UCSD-E4E/FishSense-PIO/fishsense2.step

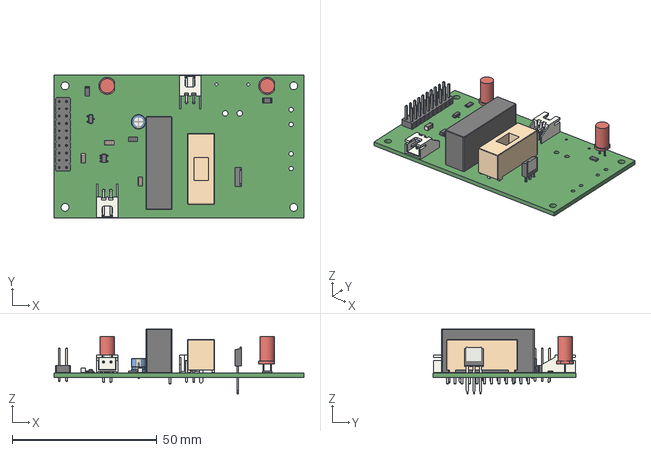
[picture p1: CAD file, 2021-12-12]
fishsense2.step
86.4 x 49.5 x 22.4 mm
