UCSD-E4E/FishSense-PIO/fishsense2.kicad_pcb

## KiCad design fishsense2.kicad_pcb (2022-05-04)

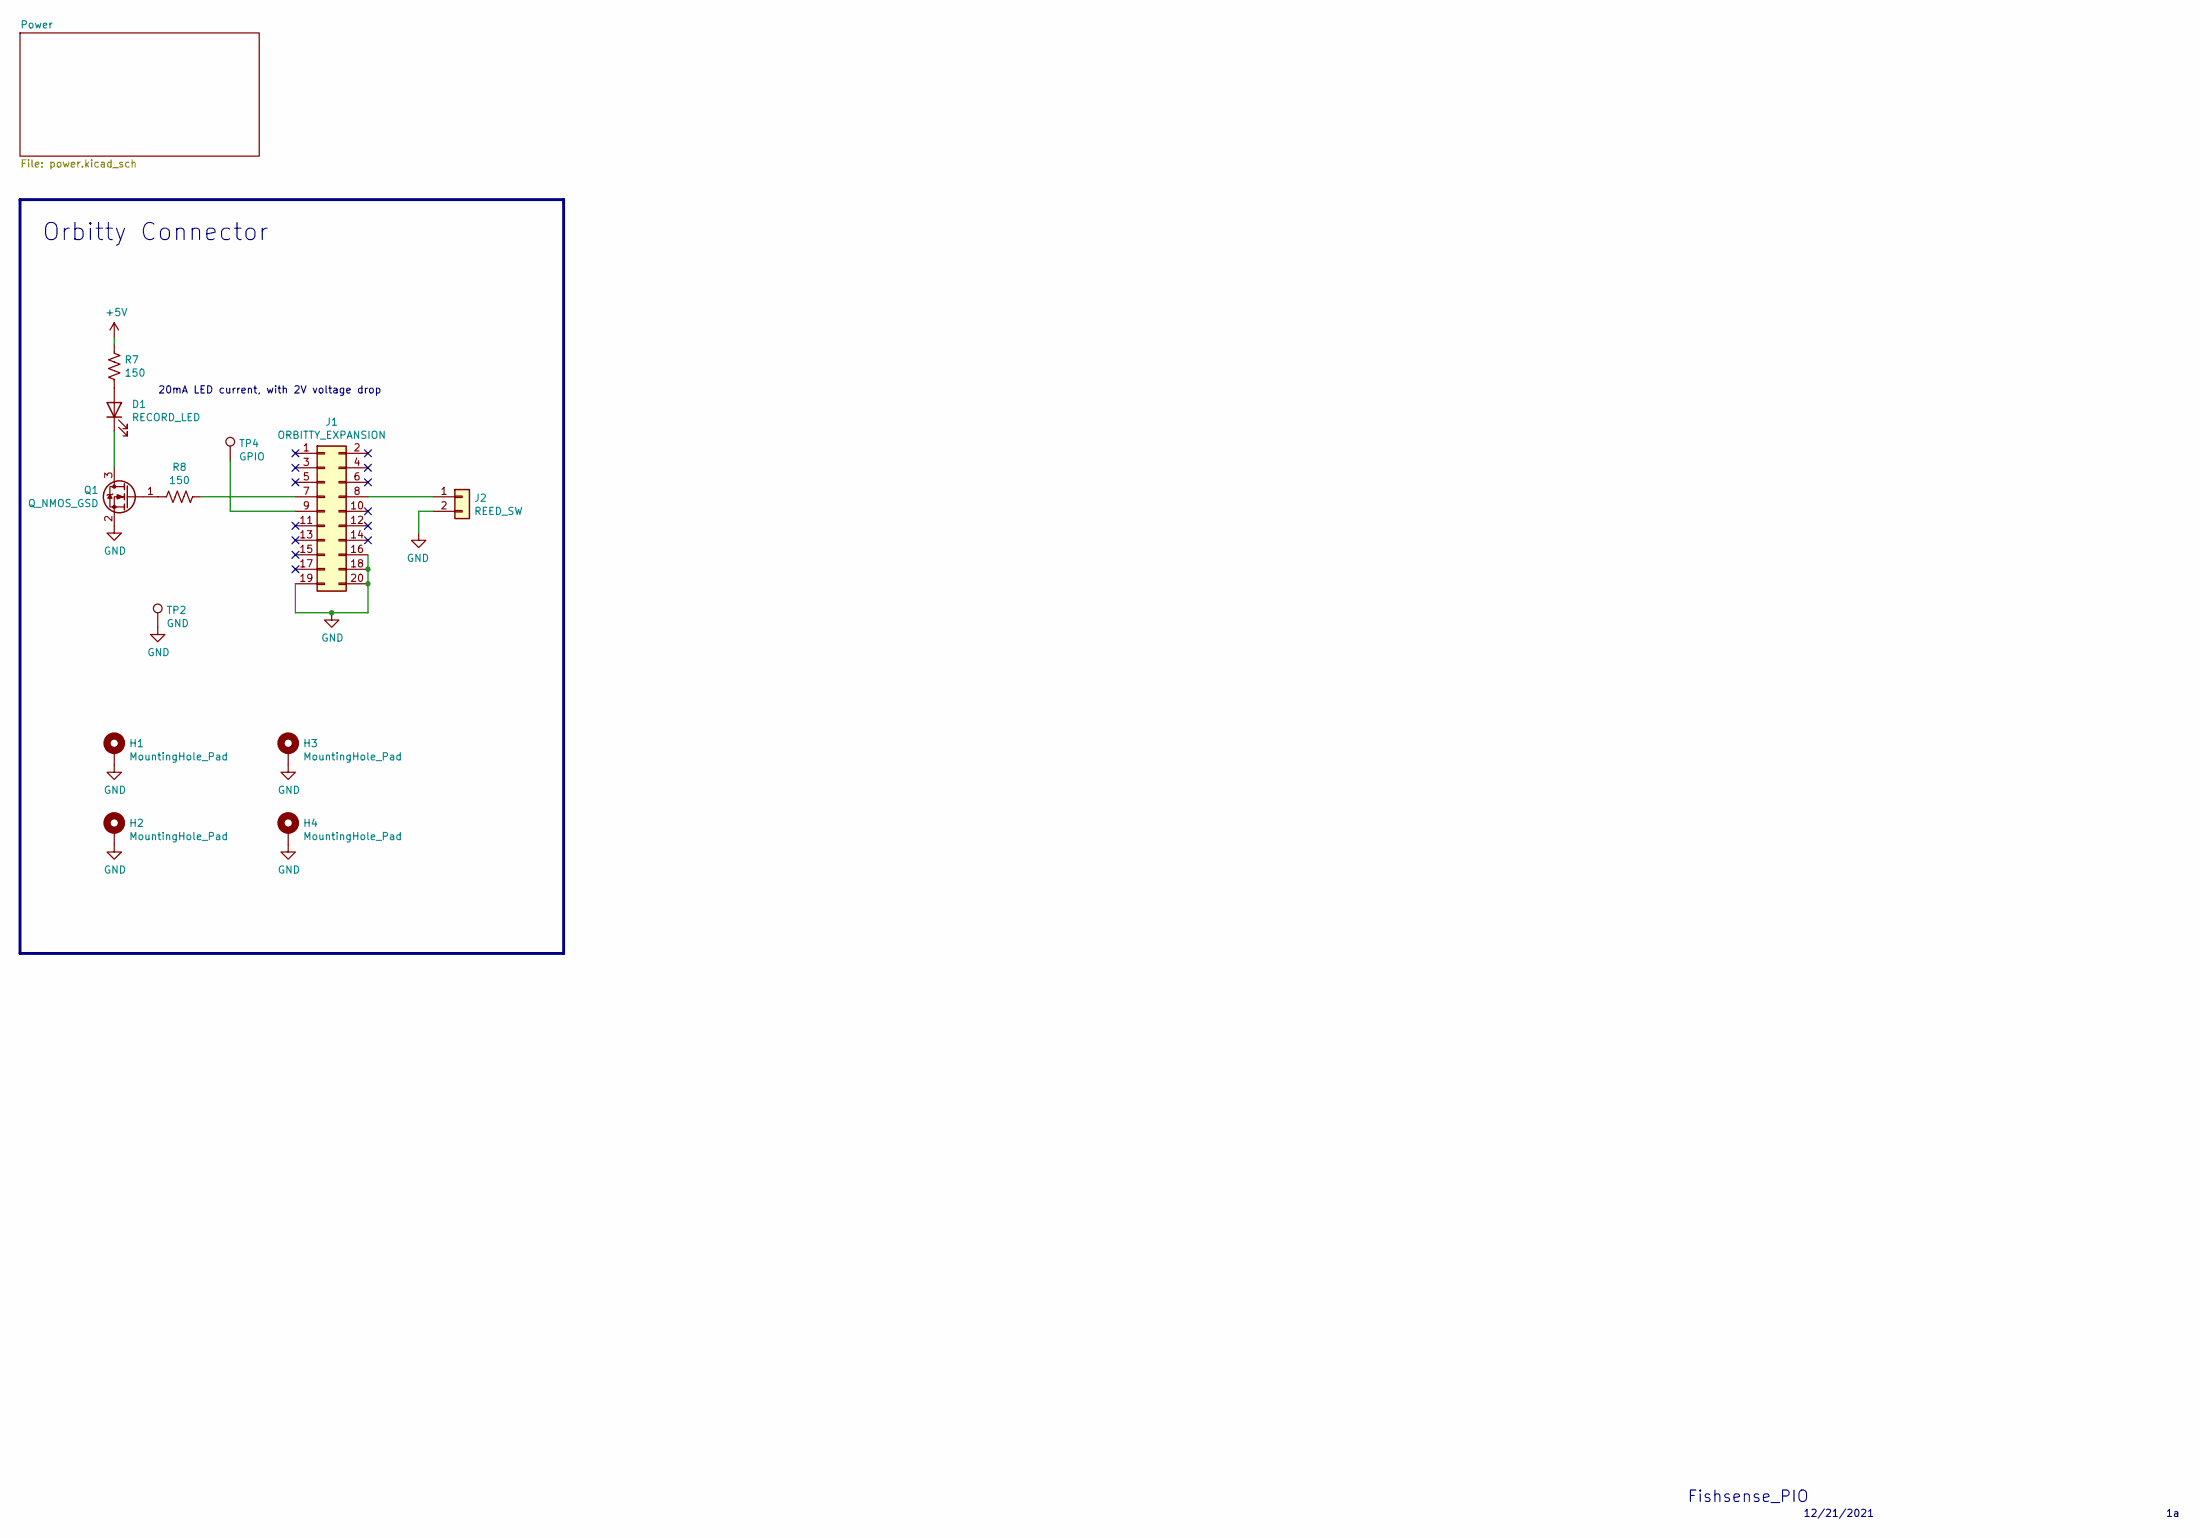
[picture p2: schematic fishsense2.kicad_sch]

Parts:
D1: RECORD_LED; LED_D5.0mm_FlatTop
H1, H2, H3, H4: MountingHole_Pad; MountingHole_2.7mm_M2.5_Pad
J1: ORBITTY_EXPANSION; PinSocket_2x10_P2.54mm_Vertical
J2: REED_SW; JST_XH_S2B-XH-A_1x02_P2.50mm_Horizontal
Q1: Q_NMOS_GSD; SOT-23_Handsoldering
R7, R8: 150; R_1206_3216Metric_Pad1.30x1.75mm_HandSolder
TP2: GND; TestPoint_Plated_Hole_D2.0mm
TP4: GPIO; TestPoint_Plated_Hole_D2.0mm

Connections:
+5V: R7.1; also elsewhere on the board
GND: H1.1, H2.1, H3.1, H4.1, J1.16, J1.18, J1.19, J1.20, J2.2, Q1.2 (S), TP2.1; also elsewhere on the board
unnamed: D1.1 (K), Q1.3 (D)
unnamed: D1.2 (A), R7.2
unnamed: J1.7, R8.1
unnamed: J1.8, J2.1
unnamed: J1.9, TP4.1
unnamed: Q1.1 (G), R8.2

Notes on the sheet:
20mA LED current, with 2V voltage drop
12/21/2021
Orbitty Connector
Fishsense_PIO

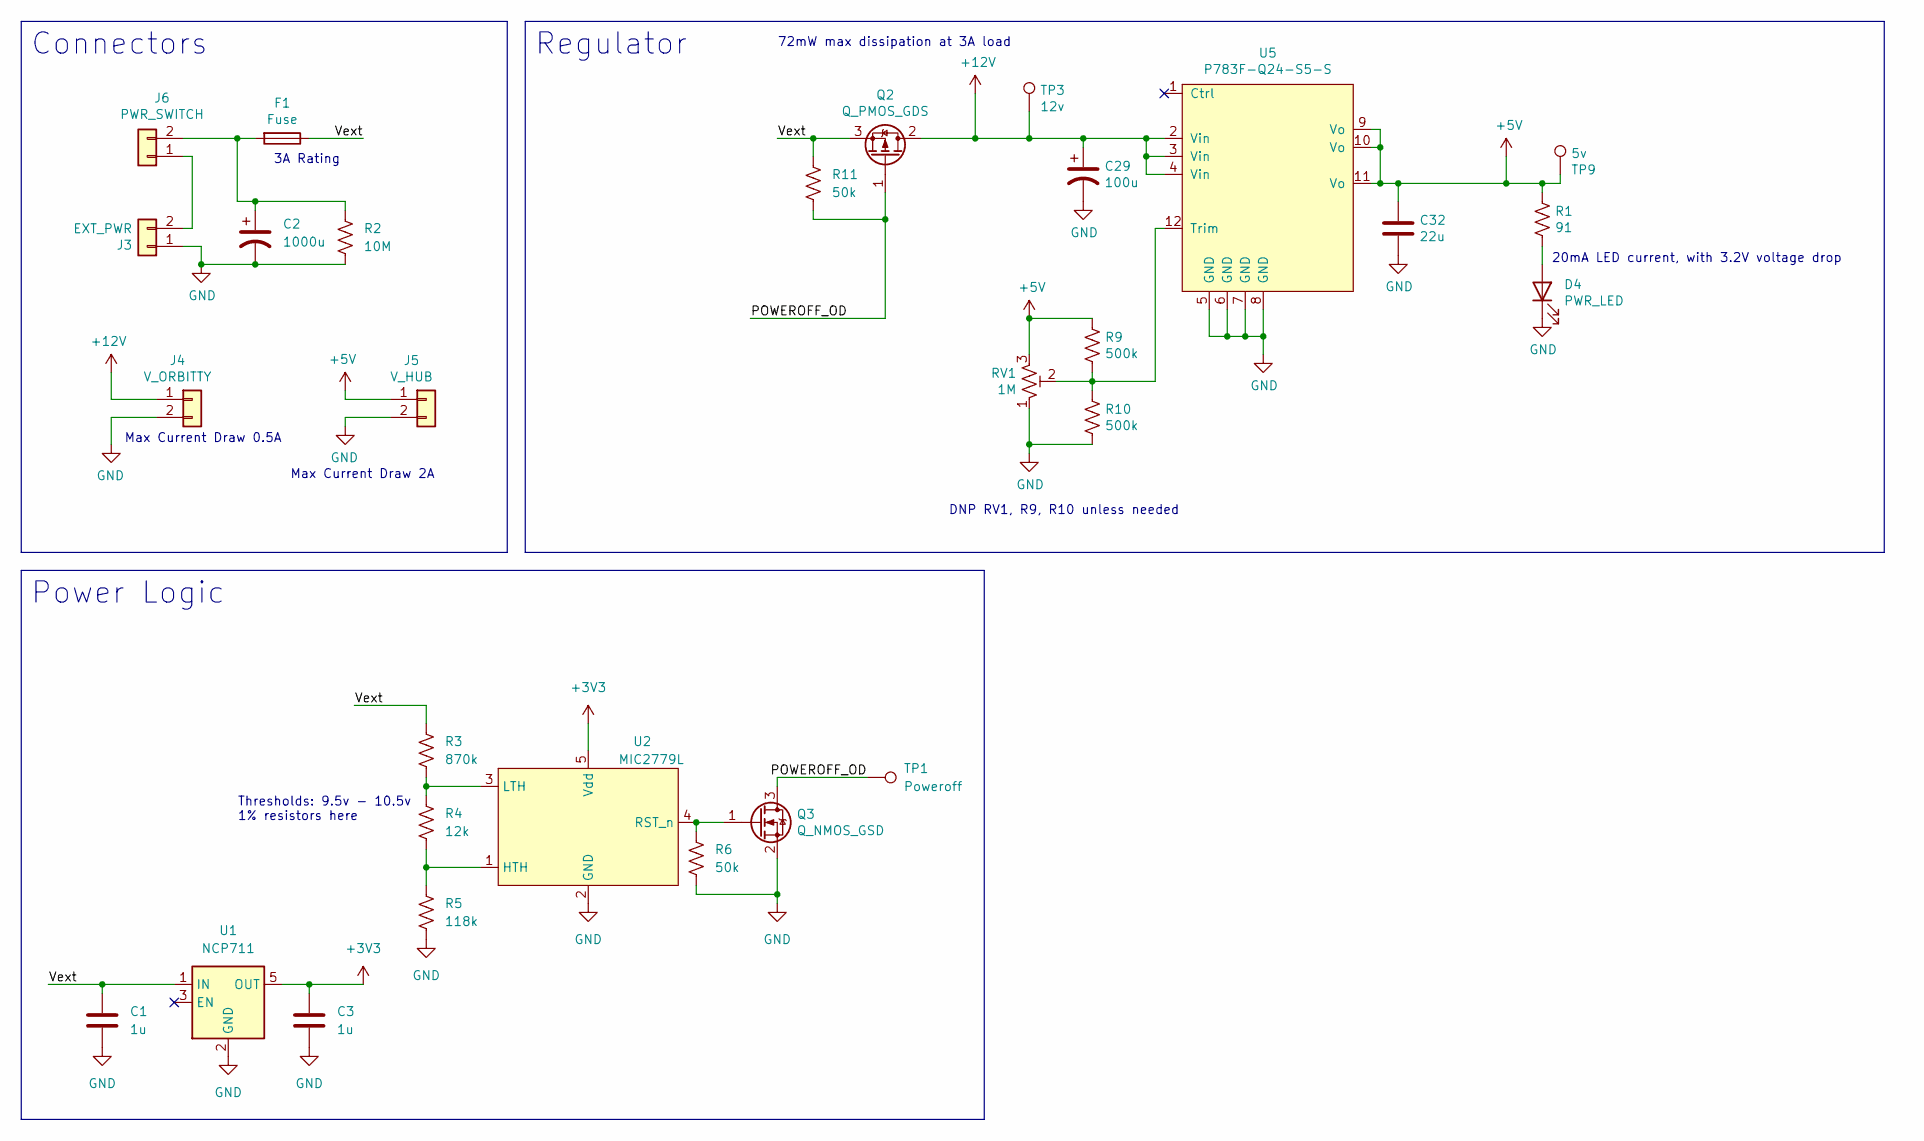
[picture p3: schematic power.kicad_sch]

Parts:
C1, C3: 1u; C_1206_3216Metric_Pad1.33x1.80mm_HandSolder
C2: 1000u; CP_Axial_L30.0mm_D12.5mm_P35.00mm_Horizontal
C29: 100u; CP_Radial_D8.0mm_P3.50mm
C32: 22u; C_1206_3216Metric_Pad1.33x1.80mm_HandSolder
D4: PWR_LED; LED_D5.0mm_FlatTop
F1: Fuse; Fuseholder_Cylinder-5x20mm_Stelvio-Kontek_PTF78_Horizontal_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
J3: EXT_PWR; AMASS_XT30PW-M_1x02_P2.50mm_Horizontal
J4: V_ORBITTY; JST_XH_S2B-XH-A_1x02_P2.50mm_Horizontal
J5: V_HUB; JST_XH_S2B-XH-A_1x02_P2.50mm_Horizontal
J6: PWR_SWITCH; JST_XH_S2B-XH-A_1x02_P2.50mm_Horizontal
Q2: Q_PMOS_GDS; TO-251-3_Vertical
Q3: Q_NMOS_GSD; SOT-23_Handsoldering
R1: 91; R_1206_3216Metric_Pad1.30x1.75mm_HandSolder
R2: 10M; R_1206_3216Metric_Pad1.30x1.75mm_HandSolder
R3: 870k; R_1206_3216Metric_Pad1.30x1.75mm_HandSolder
R4: 12k; R_1206_3216Metric_Pad1.30x1.75mm_HandSolder
R5: 118k; R_1206_3216Metric_Pad1.30x1.75mm_HandSolder
R6, R11: 50k; R_1206_3216Metric_Pad1.30x1.75mm_HandSolder
R9, R10: 500k; R_1206_3216Metric_Pad1.30x1.75mm_HandSolder
RV1: 1M; Potentiometer_Bourns_3269W_Vertical
TP1: Poweroff; TestPoint_Plated_Hole_D2.0mm
TP3: 12v; TestPoint_Plated_Hole_D2.0mm
TP9: 5v; TestPoint_Plated_Hole_D2.0mm
U1: NCP711; SOT-23-5
U2: MIC2779L; SOT-23-5
U5: P783F-Q24-S5-S; Converter_DCDC_RECOM_R5xxxPA_THT

Connections:
+3V3: C3.1, U1.5 (OUT), U2.5 (Vdd)
+5V: C32.1, J5.1, R1.1, R9.1, RV1.3, TP9.1, U5.9 (Vo), U5.10 (Vo), U5.11 (Vo); also elsewhere on the board
+12V: C29.1, J4.1, Q2.2 (D), TP3.1, U5.2 (Vin), U5.3 (Vin), U5.4 (Vin)
/Power/POWEROFF_OD: Q2.1 (G), Q3.3 (D), R11.2, TP1.1
/Power/Vext: C1.1, F1.1, Q2.3 (S), R3.1, R11.1, U1.1 (IN)
GND: C1.2, C2.2, C3.2, C29.2, C32.2, D4.1 (K), J3.1, J4.2, J5.2, Q3.2 (S), R2.2, R5.2, R6.2, R10.2, RV1.1, U1.2 (GND), U2.2 (GND), U5.5 (GND), U5.6 (GND), U5.7 (GND), U5.8 (GND); also elsewhere on the board
unnamed: C2.1, F1.2, J6.2, R2.1
unnamed: D4.2 (A), R1.2
unnamed: J3.2, J6.1
unnamed: Q3.1 (G), R6.1, U2.4 (RST_n)
unnamed: R3.2, R4.1, U2.3 (LTH)
unnamed: R4.2, R5.1, U2.1 (HTH)
unnamed: R9.2, R10.1, RV1.2, U5.12 (Trim)

Notes on the sheet:
DNP RV1, R9, R10 unless needed
Thresholds: 9.5v - 10.5v 1% resistors here
Regulator
Max Current Draw 0.5A
Connectors
3A Rating
Power Logic
20mA LED current, with 3.2V voltage drop
Max Current Draw 2A
72mW max dissipation at 3A load

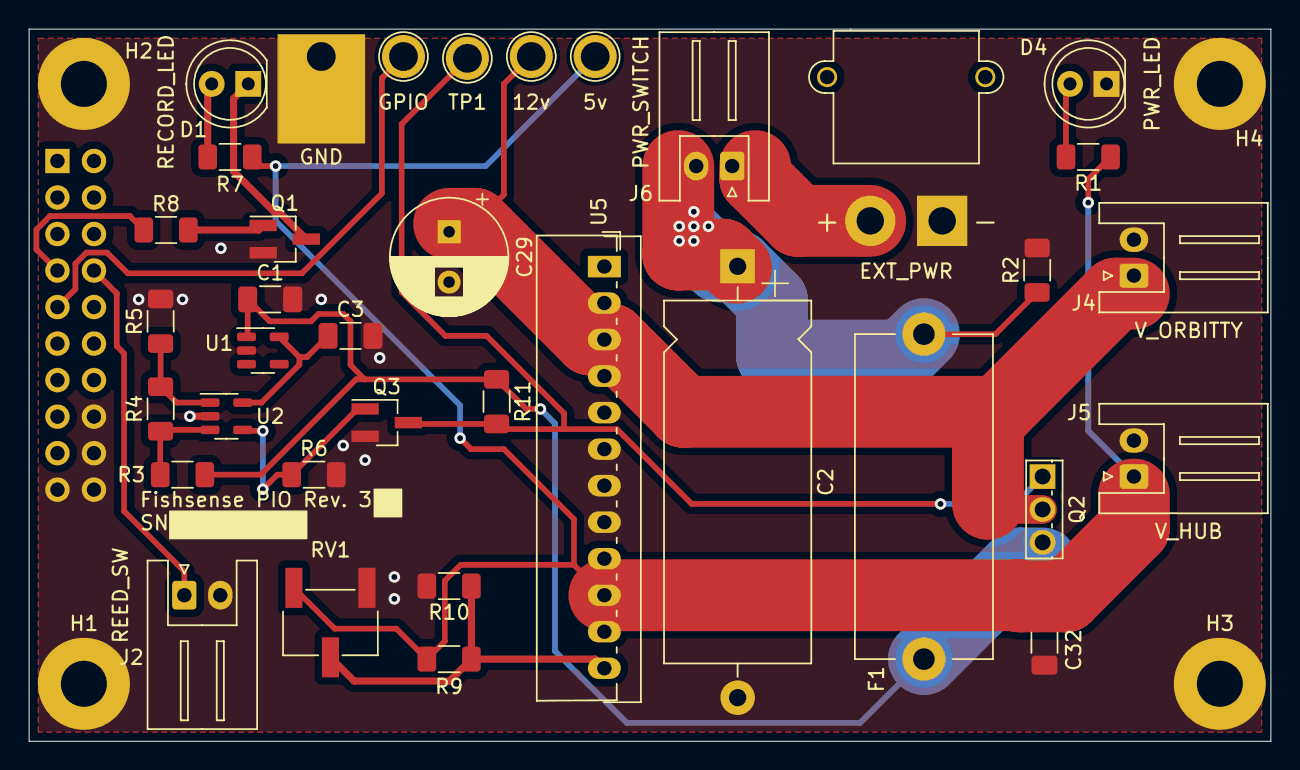
[picture p4: board fishsense2.kicad_pcb from above]

Board: 2 copper layers, 86.4 x 49.5 mm, 41 parts (1 on the bottom side), 19 nets.
