UCSD-E4E/FishSense-PIO/(commit log)

2021-10-12 General PCB layout and major part choices.
    [fishsense2.kicad_pcb, fishsense2.sch]
2021-10-18 Added symbols and footprints. More space for connectors on PCB.
    [fishsense2.kicad_pcb, fishsense2.sch]
2021-10-26 Finished schematic. Added all footprints. Arranged components and routed differential signals.
    [fishsense2.kicad_pcb, fishsense2.sch, power.sch]
2021-11-07 Small fixes to schematic.
    [power.sch]
2021-11-07 Updated footprints. Placed components and added silkscreen.
    [fishsense2.kicad_pcb, fishsense2.sch, power.sch]
2021-11-08 Changed footprints to right angle versions. Adjusted board outline to orbitty carrier size.
    [fishsense2.kicad_pcb, fishsense2.sch, power.sch]
2021-11-08 Added battery undervoltage protection, needs consideration as to whether it would work.
    [fishsense2.kicad_pcb, power.sch]
2021-11-12 Removed uneeded DC barrel power. Adjusted component values for 12v supply. Checked footprints.
    [fishsense2.kicad_pcb, fishsense2.sch, power.sch]
2021-11-13 Moved components around on PCB. Fixed fuse footprint.
    [fishsense2.kicad_pcb]
2021-11-13 Routed traces.
    [fishsense2.kicad_pcb, fishsense2.sch]
2021-12-08 Revised for BlueRobotics switch.
    [fishsense2.kicad_pcb, power.sch]
2021-12-08 Routed Traces
    [fishsense2.kicad_pcb]
2021-12-08 Added load switch
    [fishsense2.kicad_pcb, power.sch]
2021-12-08 Some footprint and part changes based on availability.
    [fishsense2.kicad_pcb, fishsense2.sch, power.sch]
2021-12-12 Replaced tps3711 with different part which is in stock.
    [fishsense2.kicad_pcb, fishsense2.step, power.sch]
2021-12-15 Swapped tps3711 for tl7702b because of availability. Added extra hysteresis to voltage supervisor.
    [fishsense2.kicad_pcb, power.sch]
2021-12-22 Many changes from first design review.
    [fishsense2.kicad_pcb, fishsense2.sch, power.sch]
2021-12-22 Added logo to PCB. Changed resistance to preferred value.
    [fishsense2.kicad_pcb, power.sch]
2022-02-11 Possible revision without feedback. Changes on schematic but not PCB.
    [fishsense2.kicad_sch, power.kicad_sch]
2022-04-16 Rev 3 Changes
    [fishsense2.kicad_pcb, fishsense2.kicad_sch, power.kicad_sch]
2022-04-16 Some footprint fixes.
    [fishsense2.kicad_pcb, fishsense2.kicad_sch, power.kicad_sch]
2022-04-20 Changed to axial capacitor, fixed mounting hole size.
    [fishsense2.kicad_pcb, fishsense2.kicad_sch, power.kicad_sch]
2022-05-04 Latest rev 3
    [fishsense2.kicad_pcb]
